li59533/HighProtectTemperatureSensor/doc/高防护_功耗说明_20200529.docx

电池容量：12Ah

工作电流：<156mA

低功耗电流：<20uA

信号良好：

理论发送次数：225000次

发送间隔2min，可工作312天。

（信号极差，工作时间缩短为104天）

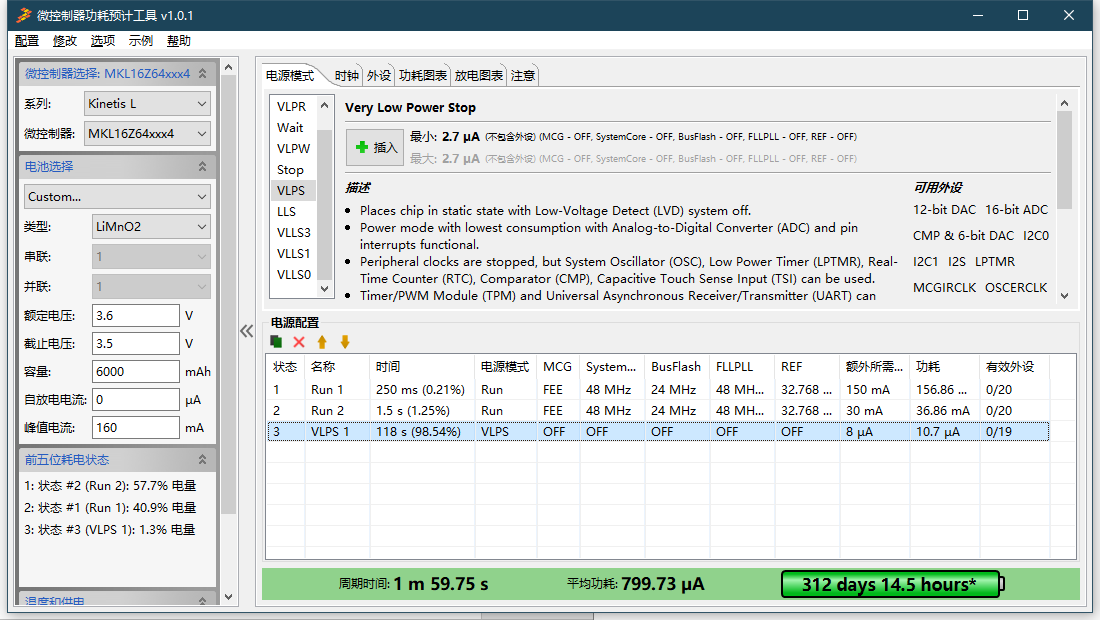
[picture p1: figure]
