li59533/HighProtectTemperatureSensor/doc/高防护_天线板_20200311.pdf

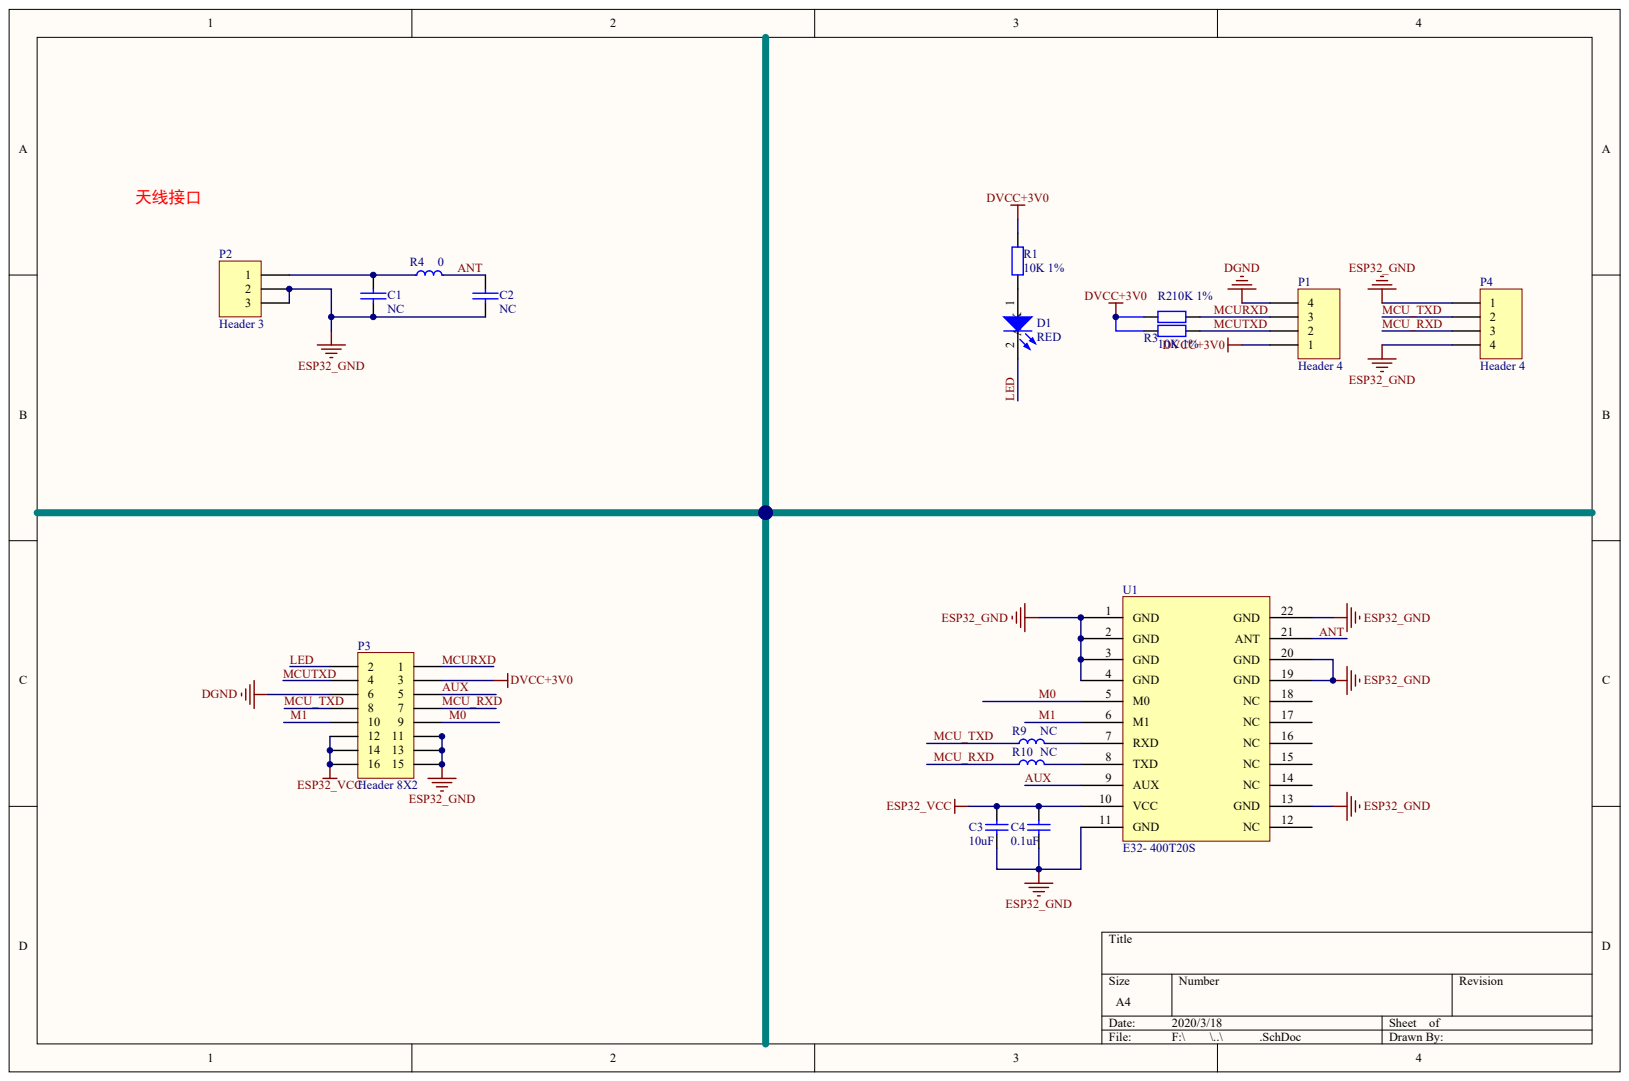
[picture p10: page 1]

Size A4 | Number | Revision

Date: 2020/3/18 | Sheet of
File: F:\ \..\ .SchDoc | Drawn By:
