li59533/HighProtectTemperatureSensor/doc/普通防护_主板_20200311.pdf

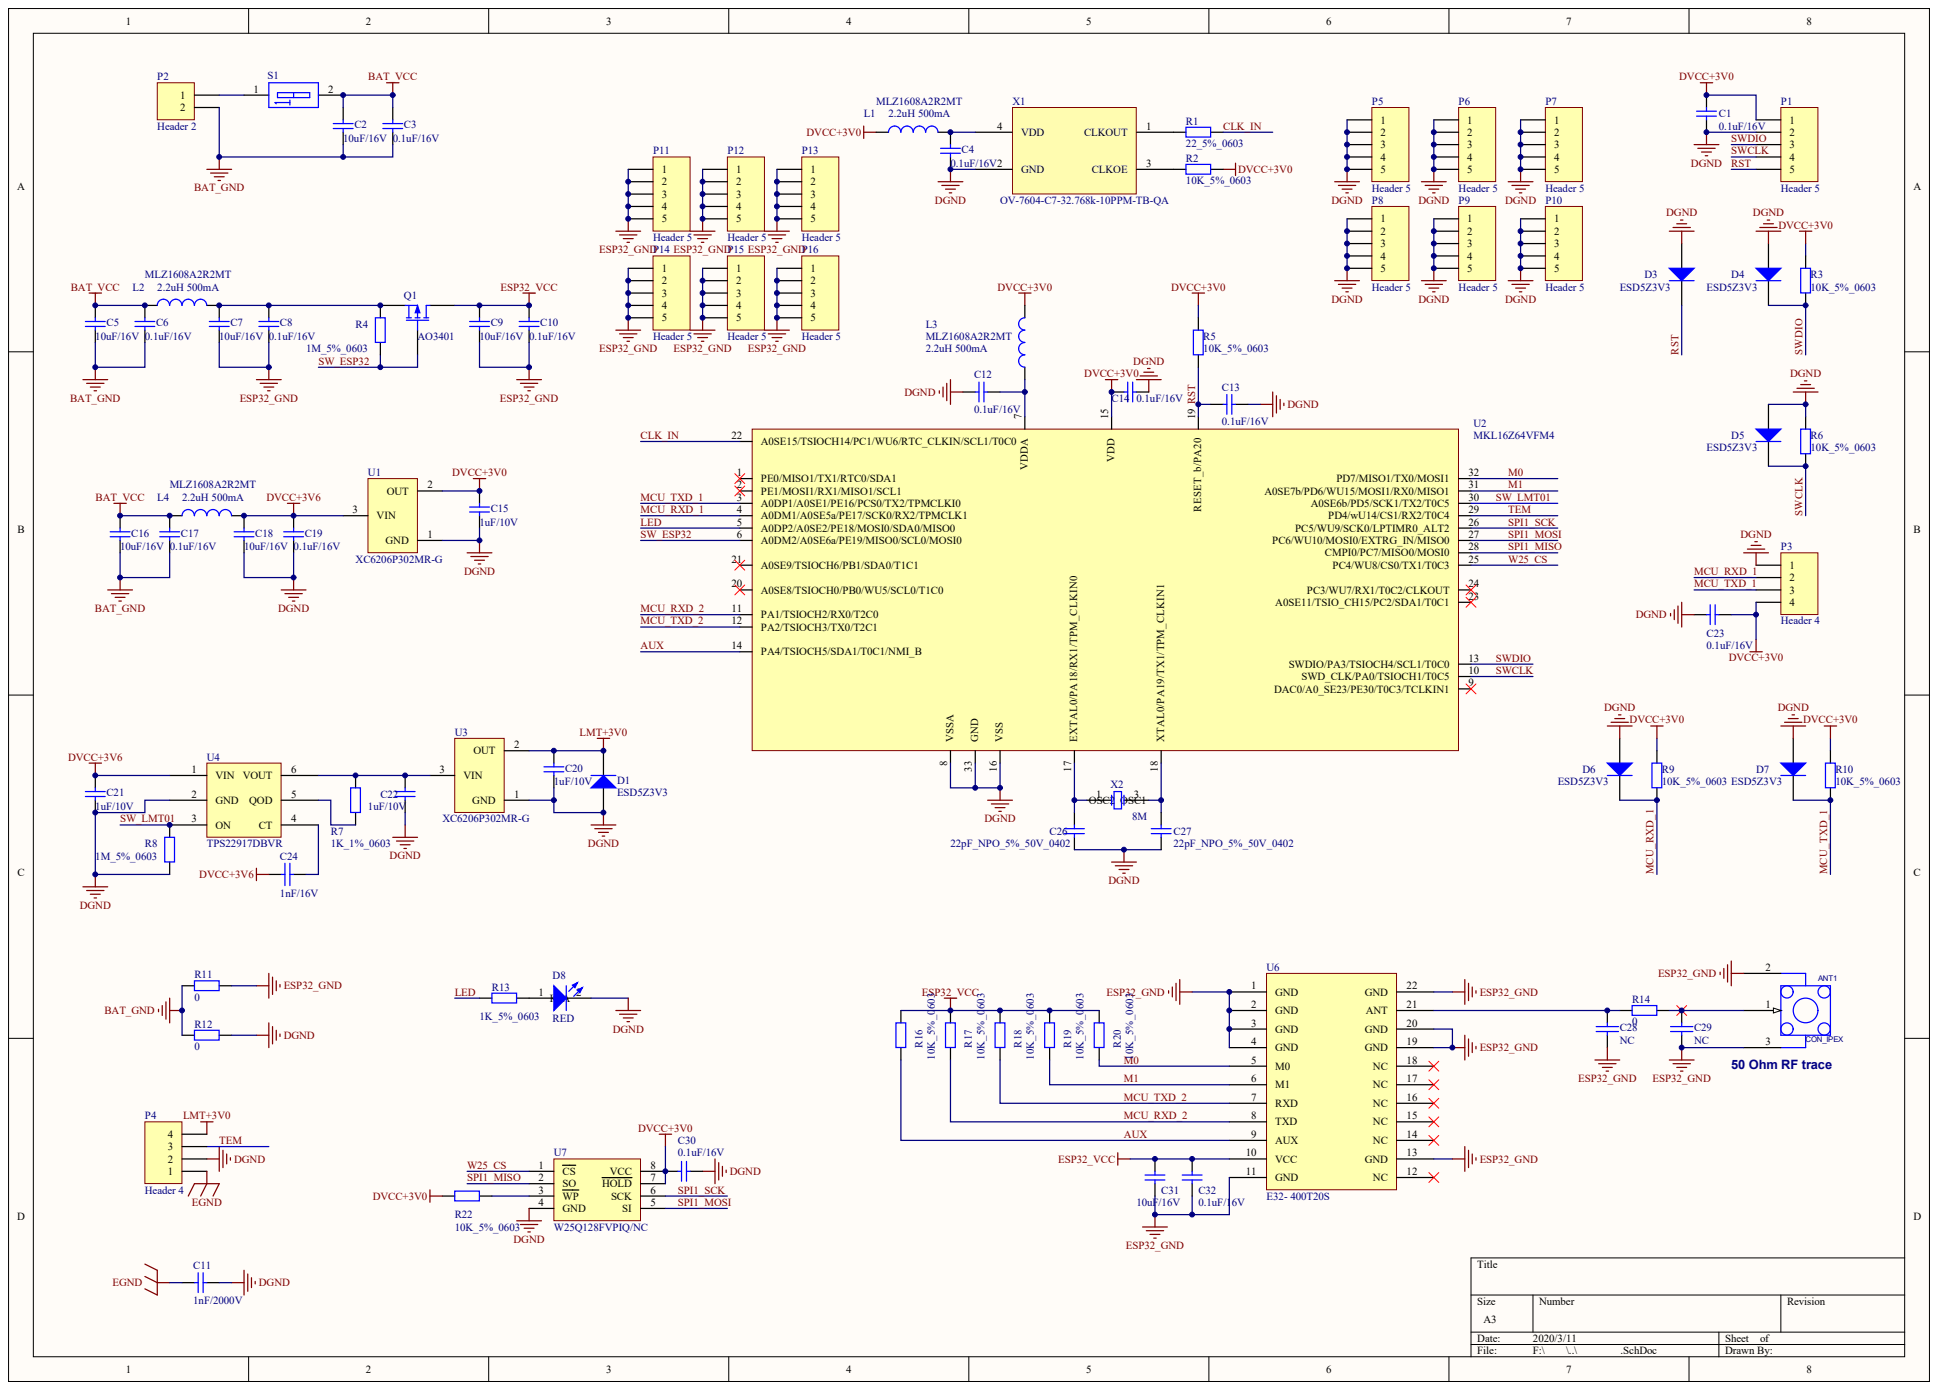
[picture p11: page 1]
