li59533/HighProtectTemperatureSensor/(commit log)

2020-03-11 高防护代码提交
    高防护代码提交
2020-03-12 V0.2.0
    -----------------------
    **发布时间：**2020.3.12
    **代码地址：**https://github.com/li59533/HighProtectTemperatureSensor.git
    **版本：**V0.2.0
    **说明：**
    1.间隔10s上报数据一次
    2.SNcode:1234567890A0AB4F
    3.源地址：0x000A
    4.目标地址：0x000B
    5.空中速率：9600
    6.配置接口：9600 8N1
    7.通道：425
    8.FFC开启
    9.基准时间：2020.1.2. 3:4:5
    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
2020-04-01 备份提交
    备份提交
